jmlzone/freETarget/fpga/pinUsage.ods

Sheet: FPGA pins
# Pin Out For iCE5UP5K (iCE40 UltraPlus - 5K)
# Revision 0.4 - Remove FWG49
# Revision 1.1 - Fix RGB pins, swapped C5 & A5 pins as well as 39 & 41
# Updated Jun 19, 2017
FNC | Pin Type | BANK | Differential Pair | SG48 | Etarget usage | ESP32 pin | UPDunio use
IOB_0a | PIO | 2 |  | 46 | pcm0
IOB_2a | DPIO | 2 | TRUE_of_IOB_3b | 47 | SD0+
IOB_3b_G6 | DPIO/GBIN | 2 | COMP_of_IOB_2a | 44 | SD0-
IOB_4a | DPIO | 2 | TRUE_of_IOB_5b | 48 | SD1+
IOB_5b | DPIO | 2 | COMP_of_IOB_4a | 45 | SD1-
IOB_6a | PIO | 2 |  | 2 | pcm1
IOB_8a | DPIO | 2 | TRUE_of_IOB_9b | 4 | SD2+
IOB_9b | DPIO | 2 | COMP_of_IOB_8a | 3 | SD2-
creset_b | CONFIG | 1 |  | 8 | Config | y |  | prog
CDONE | CONFIG | 1 |  | 7 | Config | y |  | prog
IOB_13b | DPIO | 1 | COMP_of_IOB_12a | 6 | pcm2
IOB_16a | PIO | 1 |  | 9 | pcm3 |  |  | flash
IOB_18a | PIO | 1 |  | 10 | pcm4
IOB_20a | PIO | 1 |  | 11 | pcm5
IOB_22a | DPIO | 1 | TRUE_of_IOB_23b | 12 | SD3+
IOB_23b | DPIO | 1 | COMP_of_IOB_22a | 21 | SD3-
IOB_24a | DPIO | 1 | TRUE_of_IOB_25b | 13 | SD4+
IOB_25b_G3 | DPIO/GBIN | 1 | COMP_of_IOB_24a | 20 | SD4- |  | 12mHZ | flash
IOB_29b | PIO | 1 |  | 19
IOB_31b | PIO | 1 |  | 18
IOB_32a_SPI_SO | DPIO/CONFIG_SPI | 1 |  | 14 | config/ | y |  | prog
IOB_33b_SPI_SI | DPIO/CONFIG_SPI | 1 |  | 17 | config/ | y |  | prog
IOB_34a_SPI_SCK | DPIO/CONFIG_SPI | 1 |  | 15 | config/SCL | y |  | prog
IOB_35b_SPI_SS | DPIO/CONFIG_SPI | 1 |  | 16 | config/SDA | y |  | prog
VCCPLL | VCCPLL |  |  | 29 | power
IOT_36b | DPIO/I3C | 0 | COMP_of_IOT_37a | 25 | SD5-
IOT_37a | DPIO/I3C | 0 | TRUE_of_IOT_36b | 23 | SD5+
IOT_38b | DPIO | 0 | COMP_of_IOT_39a | 27 | compN
IOT_39a | DPIO | 0 | TRUE_of_IOT_38b | 26 | compE
IOT_41a | PIO | 0 |  | 28 | compS
IOT_42b | DPIO | 0 | COMP_of_IOT_43a | 31 | compW
IOT_43a | DPIO | 0 | TRUE_of_IOT_42b | 32
IOT_44b | DPIO | 0 | COMP_of_IOT_45a | 34
IOT_45a_G1 | DPIO/GBIN | 0 | TRUE_of_IOT_44b | 37
IOT_46b_G0 | DPIO/GBIN | 0 |  | 35 | 64 mhz clock
IOT_48b | DPIO | 0 | COMP_of_IOT_49a | 36 | DIP_A
IOT_49a | DPIO | 0 | TRUE_of_IOT_48b | 43 | DIP_B
IOT_50b | DPIO | 0 | COMP_of_IOT_51a | 38 | DIP_C
IOT_51a | DPIO | 0 | TRUE_of_IOT_50b | 42 | DIP_D
RGB2 | LED | 0 |  | 41 |  |  |  | led
RGB1 | LED | 0 |  | 40 |  |  |  | led
RGB0 | LED | 0 |  | 39 |  |  |  | led
GND | GND | GND |  | Paddle | GND
GND | GND | GND |  | Paddle | GND
GND | GND | GND |  | Paddle | GND
VCC | VCC | VCC |  | 5 | power
VCC | VCC | VCC |  | 30 | power
VCCIO_0 | VCCIO | 0 |  | 33 | power
SPI_Vccio1 | VCCIO | 1 |  | 22 | power
VCCIO_2 | VCCIO | 2 |  | 1 | power
VPP_2V5 | VPP | VPP |  | 24 | power
*SG48 GND is connected to package paddle |  |  |  |  |  | m

Sheet: ESP32 pins
ESP32-WROOM-23D_DEV | U | ESP32-DevKitC |  | usage
Pin | Name | Side | Type
1 | VDD33 | left | power | power
2 | en | left | input | nc
3 | A0_IO36 | left | pass | V_REFERENCE | retro compat
4 | A3_IO39 | left | pass | NORTH_ANA | retro compat
5 | A6_IO34 | left | pass | EAST_ANA | retro compat
6 | A7_IO35 | left | pass | SOUTH_ANA | retro compat
7 | A4_IO32 | left | pass | WEST_ANA | retro compat
8 | A5_IO33 | left | pass | SPARE_1
9 | A18_IO25 | left | pass | SPARE_2
10 | A19_IO26 | left | pass | LED_PWM
11 | A17_IO27 | left | pass | RTS_U
12 | A16_IO14 | left | pass | CST_U
13 | A15_IO12 | left | pass | usb2 | DISP TX
14 | GND | left | ground | ground
15 | A14_IO13 | left | pass | usb2 | DISP RX
16 | D2_IO9 | left | pass
17 | D3_IO10 | left | pass
18 | CMD_IO_11 | left | pass
19 | VIN_5V | left | power | power
38 | GND | right | ground | ground
37 | IO23 | right | bidir | vspimosi | to fpspi in
36 | IO22 | right | bidir | Pixels
35 | TX0_IO1 | right | bidir | usb uart | nc
34 | RX0_IO3 | right | bidir | usb uart | nc
33 | IO21 | right | bidir | paper
32 | GND | right | ground | ground
31 | IO19 | right | bidir
30 | IO18 | right | bidir | vspiclk | to spi clock | i2c scl
29 | IO5 | right | bidir | vspics “SS” | to fpga cs | I2c SDA
28 | IO17 | right | bidir | ARX | AUX RX
27 | IO16 | right | bidir | ATX | AUX TX
26 | A10_IO4 | right | pass | FACE_SENSOR
25 | A11_IO0 | right | pass | creset_b | pwm at boot
24 | A12_IO2 | right | pass | cdone | onboard led
23 | A13_IO15 | right | pass | BD_REV
22 | SDI_IO8 | right | bidir
21 | SDO_IO7 | right | bidir
20 | SCK_IO6 | right | bidir
 | not reccomended to use
