jmlzone/freETarget/Documentation/Commissioning.docx

# freETarget

Application Note: Commissioning

SUMMARY

This application note describes the steps needed to put a freETarget into service and trouble shoot problems as they arise.

REQUIRED

- freETarget V2.1 or higher
- Firmware V3.0 or higher

INTRODUCTION

freETarget has built in test software that helps to identify problems in the installation and ensure correct operation.

IMPORTANT

Your freETarget was tested when it was assembled and arrived with the latest firmware and calibrated. Straight out of the box it should work first shot (pun intended).

INSPECTION

After you have assembled the freETarget into the target holder, inspect the following

- The flat cable is pressed firmly into the sensors and signal board
- There are no kinks or sharp bends in the flat cable.
- All of the sensors are correctly installed North through West

POWER ON

When powered on, the LEDs will go through a short cycle RDY – X – Y to indicate that the power has been applied, the software is valid, and the circuit is functioning. See Figure 1 to see the expected operation.

| | | RDY | X | Y
LED
Test
Cycle
Test Timer Circuit
Display Set Point | | | show | set | point
Ready for Operation

Figure 1: Power On Test Cycle

SENSOR TEST

At the beginning of each cycle, the software does a quick check to make sure that the hardware is ready for the next shot. If no errors are found, the RDY LED is illuminated and the circuit is ready to go. If a sensor is not detected, the fault LED is lit and the remaining LEDs are used to identify the faulty sensor

| | | RDY | X | Y
Ready for Operation
North Sensor Failed
East Sensor Failed
South Sensor Failed
West Sensor Failed

Figure 2: Sensor Fault Indication

If the sensors show ready for operation, tapping the face of the sensor will trigger a shot and indicate that the sensor is capable of detecting the projectile. In Figure 3, all of the LEDs are briefly illuminated to show that the shot was detected and sent to the PC.

| | | RDY | X | Y
Ready for Operation
Shot Detected
Ready for Next Shot

Figure 3: LEDs During and After a Shot

CONNECTING TO THE PC

Launch the PC program and make sure that the correct COM port has been selected.

- Press the Setup Icon (Gear Wheel)
- Inspect Hardware
- Verify that the correct COM port is used.
- Press the CONNECT button on the PC program
  - Does the program show CONNECTED?
  - The current firmware version and date is shown?
  - The competition timer starts running?
  - If the answer is no to any of these questions, check the USB cables and the selected COM port

FIRST SHOT

From a distance of 10 meters, fire your first shot into the target.

- Does the shot register on the PC program?
  - No, check the cables and settings

Fire a series of 9 more shots onto the target.

- Do all 10 shots show up on the display?
  - No, check the cables and settings
- Are the shots more-or-less in the correct place?
  - You’re done. Happy Shooting
- Are the shots correct, but the mirror image?
  - The sensors are installed correctly, but mirror image.
  - Swap North and East
  - Swap West and South
  - Go back to the beginning and test the circuit.
- Are the shots correct, but the reversed top and bottom?
  - The sensors are installed correctly, but upside down.
  - Swap North and West
  - Swap South and East
  - Go back to the beginning and test the circuit.

SET TRIGGER POINT

At this moment, your freETarget is working correctly. Once you get confident in how it works, you might want to change the trigger point and try to improve the accuracy. Refer to the Application Note: Setting the Trigger Point for more instructions.
