jmlzone/freETarget/KiCad/Main Board/Electronic Target.pdf

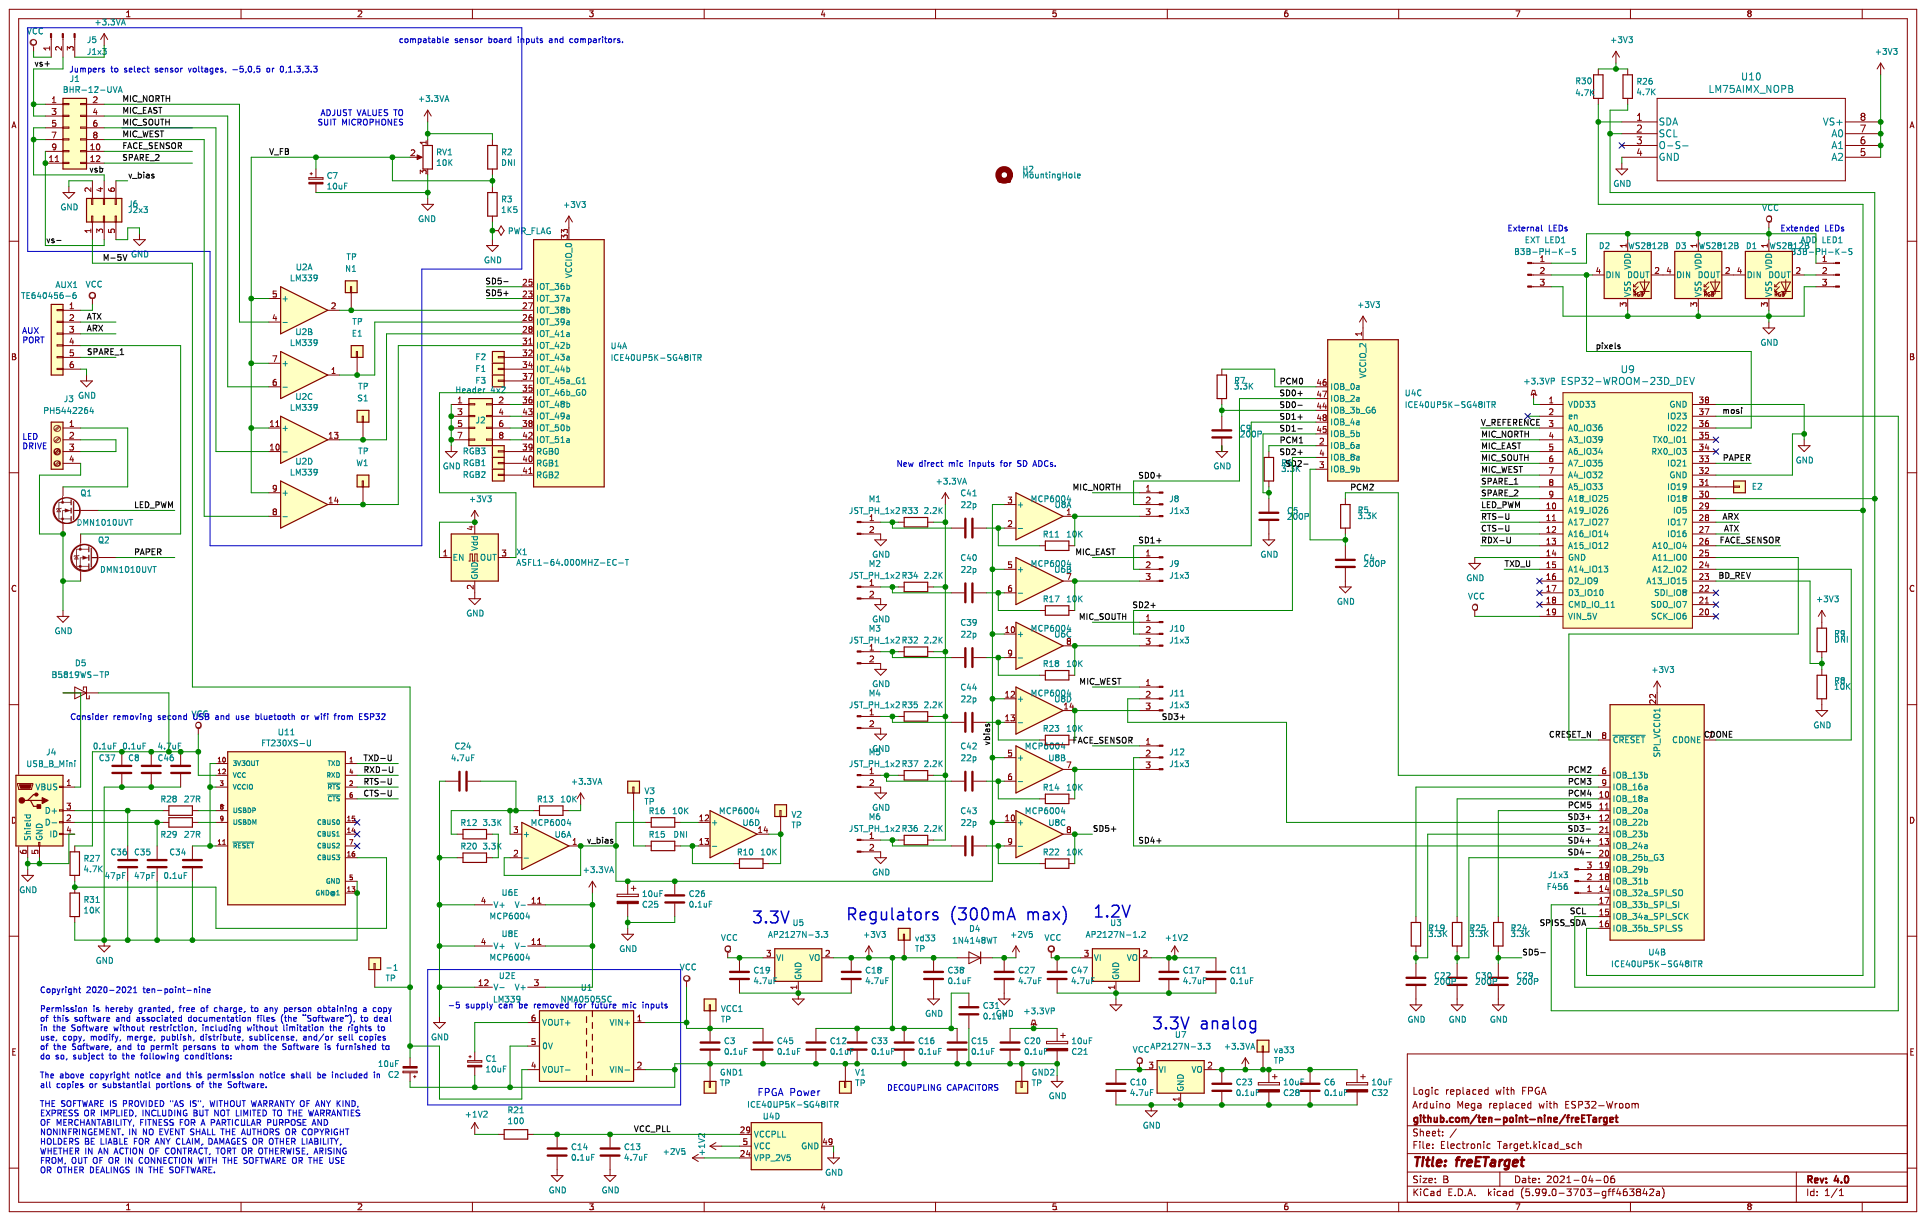
[picture p7: page 1]
