jmlzone/freETarget/KiCad/Main Board/Electronic Target.kicad_sch

## KiCad design KiCad/Main Board/Electronic Target.kicad_sch (2021-06-01)

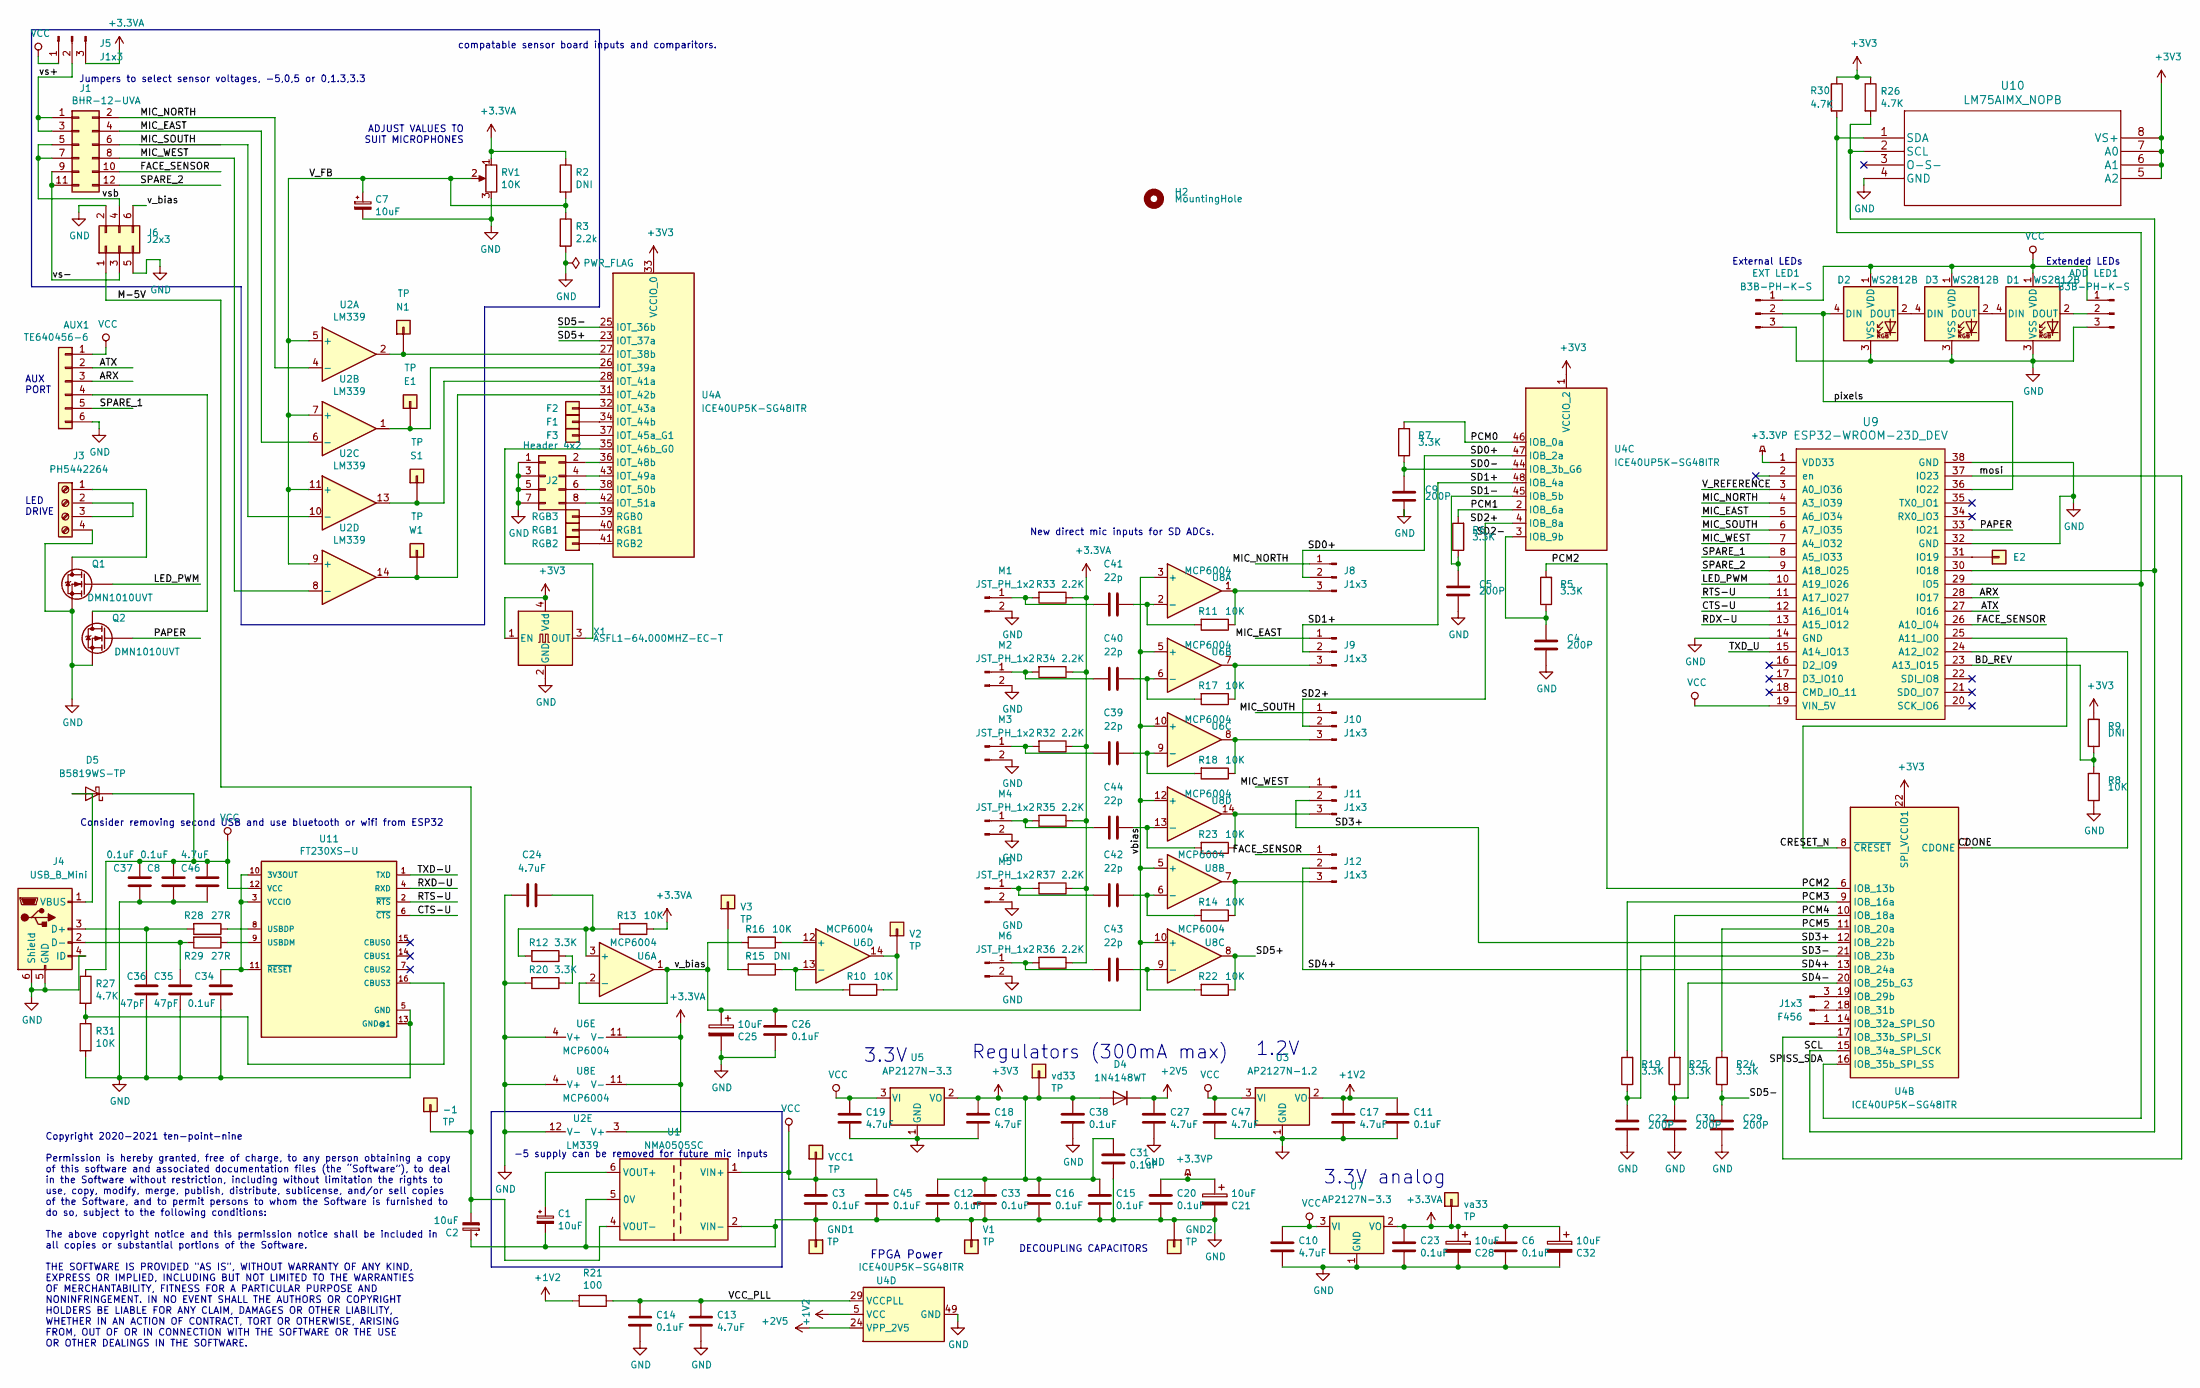
[picture p8: schematic Electronic Target.kicad_sch]

Parts:
-1: TP; PinHeader_1x01_P2.54mm_Vertical
ADD LED1: B3B-PH-K-S; JST_EH_B3B-EH-A_1x03_P2.50mm_Vertical
AUX1: TE640456-6; PinHeader_1x06_P2.54mm_Vertical
C1: 10uF; C_0603_1608Metric; Digikey 478-10742-1-ND
C2: 10uF; C_0603_1608Metric; DigiKey 478-10742-1-ND
C3, C6, C8, C11, C12, C14, C15, C16, C20, C23, C26, C31, C33, C34, C37, C38, C45: 0.1uF; C_0603_1608Metric
C4, C5, C9, C22, C29, C30: 200P; C_0603_1608Metric
C7, C21, C25, C28, C32: 10uF; C_0603_1608Metric
C10, C13, C17, C18, C19, C24, C27, C46, C47: 4.7uF; C_0603_1608Metric
C35, C36: 47pF; C_0603_1608Metric
C39, C40, C41, C42, C43, C44: 22p; C_0603_1608Metric
D1, D2, D3: WS2812B; LED_WS2812B_PLCC4_5.0x5.0mm_P3.2mm
D4: 1N4148WT; D_SOD-523
D5: B5819WS-TP; D_SOD-323
E1, E2: TP; PinHeader_1x01_P2.54mm_Vertical
EXT LED1: B3B-PH-K-S; JST_EH_B3B-EH-A_1x03_P2.50mm_Vertical
F1, F2, F3: TP; PinHeader_1x01_P2.54mm_Vertical
F456: J1x3; PinSocket_1x03_P2.54mm_Vertical
GND1, GND2: TP; PinHeader_1x01_P2.54mm_Vertical
H2: MountingHole; MountingHole_3.7mm
J1: BHR-12-UVA; PinHeader_2x06_P2.54mm_Vertical
J2: Header 4x2; PinHeader_2x04_P2.54mm_Vertical
J3: PH5442264; TerminalBlock_Phoenix_PT-1,5-4-3.5-H_1x04_P3.50mm_Horizontal
J4: USB_B_Mini; USB_Mini-B_Lumberg_2486_01_Horizontal
J5, J8, J9, J10, J11, J12: J1x3; PinSocket_1x03_P2.54mm_Vertical
J6: J2x3; PinHeader_2x03_P2.54mm_Vertical
M1, M2, M3, M4, M5, M6: JST_PH_1x2; JST_PH_B2B-PH-K_1x02_P2.00mm_Vertical
N1: TP; PinHeader_1x01_P2.54mm_Vertical
Q1, Q2: DMN1010UVT; TSOT-23-6
R2, R9, R15: DNI; R_0603_1608Metric
R3: 2.2k; R_0603_1608Metric
R5, R6, R7, R12, R19, R20, R24, R25: 3.3K; R_0603_1608Metric
R8, R10, R11, R13, R14, R16, R17, R18, R22, R23, R31: 10K; R_0603_1608Metric
R21: 100; R_0603_1608Metric
R26, R27, R30: 4.7K; R_0603_1608Metric
R28, R29: 27R; R_0603_1608Metric
R32, R33, R34, R35, R36, R37: 2.2K; R_0603_1608Metric
RGB1, RGB2, RGB3: TP; PinHeader_1x01_P2.54mm_Vertical
RV1: 10K; Potentiometer_Bourns_3314S_Horizontal; DigiKey 987-1014-1-ND
S1: TP; PinHeader_1x01_P2.54mm_Vertical
U1: NMA0505SC; Converter_DCDC_muRata_NMAxxxxSC_THT
U2: LM339; SOIC-14_3.9x8.7mm_P1.27mm
U3: AP2127N-1.2; SOT-23
U4: ICE40UP5K-SG48ITR; QFN-48-1EP_7x7mm_P0.5mm_EP5.6x5.6mm
U5, U7: AP2127N-3.3; SOT-23
U6, U8: MCP6004; SOIC-14_3.9x8.7mm_P1.27mm
U9: ESP32-WROOM-23D_DEV; ESP32-DEVKIT
U10: LM75AIMX_NOPB; SOIC-8_3.9x4.9mm_P1.27mm
U11: FT230XS-U; SSOP-16_3.9x4.9mm_P0.635mm
V1, V2, V3: TP; PinHeader_1x01_P2.54mm_Vertical
VCC1: TP; PinHeader_1x01_P2.54mm_Vertical
W1: TP; PinHeader_1x01_P2.54mm_Vertical
X1: ASFL1-64.000MHZ-EC-T; Oscillator_SMD_Abracon_ASE-4Pin_3.2x2.5mm
va33: TP; PinHeader_1x01_P2.54mm_Vertical
vd33: TP; PinHeader_1x01_P2.54mm_Vertical

Connections:
+1V2: C11.1, C17.1, R21.2, U3.2 (VO), U4.5 (VCC), U4.30 (VCC)
+2V5: C27.1, D4.1 (K), U4.24 (VPP_2V5)
+3.3VA: C6.1, C23.1, C28.1, C32.1, J5.3, R2.1, R13.1, R32.1, R33.1, R34.1, R35.1, R36.1, R37.1, RV1.1, U2.3 (V+), U6.11 (V-), U7.2 (VO), U8.11 (V-), va33.1
+3.3VP: C20.1, C21.1, U9.1 (VDD33)
+3V3: C12.1, C15.1, C16.1, C18.1, C31.1, C33.1, C38.1, D4.2 (A), R9.2, R26.1, R30.1, U4.1 (VCCIO_2), U4.22 (SPI_VCCIO1), U4.33 (VCCIO_0), U5.2 (VO), U10.5 (A2), U10.6 (A1), U10.7 (A0), U10.8 (VS+), X1.1 (EN), X1.4 (Vdd), vd33.1
ARX: AUX1.3, U9.28 (IO17)
ATX: AUX1.2, U9.27 (IO16)
BD_REV: R8.2, R9.1, U9.23 (A13_IO15)
CDONE: U4.7 (CDONE), U9.24 (A12_IO2)
CRESET_N: U4.8 (~CRESET), U9.25 (A11_IO0)
CTS-U: U9.12 (A16_IO14), U11.6 (~CTS)
FACE_SENSOR: J1.10, J12.1, U9.26 (A10_IO4)
GND: ADD LED1.3, AUX1.6, C1.2, C2.1, C3.2, C4.2, C5.2, C6.2, C7.2, C8.2, C9.2, C10.2, C11.2, C12.2, C13.2, C14.2, C15.2, C16.2, C17.2, C18.2, C19.2, C20.2, C21.2, C22.2, C23.2, C24.2, C25.2, C26.2, C27.2, C28.2, C29.2, C30.2, C31.2, C32.2, C33.2, C34.2, C35.2, C36.2, C37.2, C38.2, C45.2, C46.2, C47.2, D1.3 (VSS), D2.3 (VSS), D3.3 (VSS), EXT LED1.3, GND1.1, GND2.1, J2.1, J2.3, J2.5, J2.7, J3.4, J4.4 (ID), J4.5 (GND), J4.6 (Shield), J6.2, J6.5, M1.2, M2.2, M3.2, M4.2, M5.2, M6.2, Q1.4 (S), Q2.4 (S), R3.2, R8.1, R20.2, R31.2, RV1.3, U1.2 (VIN-), U1.5 (0V), U2.12 (V-), U3.1 (GND), U4.49 (GND), U5.1 (GND), U6.4 (V+), U7.1 (GND), U8.4 (V+), U9.14 (GND), U9.32 (GND), U9.38 (GND), U10.4 (GND), U11.5 (GND), U11.13 (GND@1), V1.1, X1.2 (GND)
LED_PWM: Q1.3 (G), U9.10 (A19_IO26)
M-5V: -1.1, C2.2, J6.1, U1.4 (VOUT-)
MIC_EAST: J1.4, J9.1, U2.6 (-), U9.5 (A6_IO34)
MIC_NORTH: J1.2, J8.1, U2.4 (-), U9.4 (A3_IO39)
MIC_SOUTH: J1.6, J10.1, U2.10 (-), U9.6 (A7_IO35)
MIC_WEST: J1.8, J11.1, U2.8 (-), U9.7 (A4_IO32)
unnamed: ADD LED1.2, D1.2 (DOUT)
unnamed: AUX1.4, Q2.1 (D), Q2.2 (D), Q2.5 (D), Q2.6 (D)
unnamed: C1.1, U1.6 (VOUT+)
unnamed: C24.1, R12.2, R13.2, U6.3 (+)
unnamed: C34.1, U11.3 (VCCIO), U11.10 (3V3OUT), U11.11 (~RESET)
unnamed: C35.1, J4.2 (D-), R29.2
unnamed: C36.1, J4.3 (D+), R28.2
unnamed: C39.1, R18.2, U6.9 (-)
unnamed: C39.2, M3.1, R32.2
unnamed: C40.1, R17.2, U6.6 (-)
unnamed: C40.2, M2.1, R34.2
unnamed: C41.1, R11.2, U8.2 (-)
unnamed: C41.2, M1.1, R33.2
unnamed: C42.1, R14.2, U8.6 (-)
unnamed: C42.2, M5.1, R37.2
unnamed: C43.1, R22.2, U8.9 (-)
unnamed: C43.2, M6.1, R36.2
unnamed: C44.1, R23.2, U8.13 (-)
unnamed: C44.2, M4.1, R35.2
unnamed: D1.4 (DIN), D3.2 (DOUT)
unnamed: D2.2 (DOUT), D3.4 (DIN)
unnamed: D5.2 (A), J4.1 (VBUS)
unnamed: E1.1, U2.1, U4.26 (IOT_39a)
unnamed: E2.1, U9.31 (IO19)
unnamed: F1.1, U4.34 (IOT_44b)
unnamed: F2.1, U4.32 (IOT_43a)
unnamed: F3.1, U4.37 (IOT_45a_G1)
unnamed: F456.1, U4.14 (IOB_32a_SPI_SO)
unnamed: F456.2, U4.18 (IOB_31b)
unnamed: F456.3, U4.19 (IOB_29b)
unnamed: J2.2, U4.36 (IOT_48b)
unnamed: J2.4, U4.43 (IOT_49a)
unnamed: J2.6, U4.38 (IOT_50b)
unnamed: J2.8, U4.42 (IOT_51a)
unnamed: J3.1, Q1.1 (D), Q1.2 (D), Q1.5 (D), Q1.6 (D)
unnamed: J3.2, J3.3
unnamed: J8.3, R11.1, U8.1
unnamed: J9.3, R17.1, U6.7
unnamed: J10.3, R18.1, U6.8
unnamed: J11.3, R23.1, U8.14
unnamed: J12.3, R14.1, U8.7
unnamed: N1.1, U2.2, U4.27 (IOT_38b)
unnamed: R10.1, U6.14, V2.1
unnamed: R10.2, R15.1, U6.13 (-)
unnamed: R12.1, R20.1
unnamed: R15.2, V3.1
unnamed: R16.1, U6.12 (+)
unnamed: R27.2, R31.1, U11.16 (CBUS3)
unnamed: R28.1, U11.8 (USBDP)
unnamed: R29.1, U11.9 (USBDM)
unnamed: RGB1.1, U4.40 (RGB1)
unnamed: RGB2.1, U4.41 (RGB2)
unnamed: RGB3.1, U4.39 (RGB0)
unnamed: S1.1, U2.13, U4.28 (IOT_41a)
unnamed: U2.14, U4.31 (IOT_42b), W1.1
unnamed: U4.35 (IOT_46b_G0), X1.3 (OUT)
PAPER: Q2.3 (G), U9.33 (IO21)
PCM0: R7.2, U4.46 (IOB_0a)
PCM1: R6.2, U4.2 (IOB_6a)
PCM2: R5.2, U4.6 (IOB_13b)
PCM3: R19.2, U4.9 (IOB_16a)
PCM4: R25.2, U4.10 (IOB_18a)
PCM5: R24.2, U4.11 (IOB_20a)
RDX-U: U9.13 (A15_IO12)
RTS-U: U9.11 (A17_IO27), U11.2 (~RTS)
RXD-U: U11.4 (RXD)
SCL: R26.2, U4.15 (IOB_34a_SPI_SCK), U9.30 (IO18), U10.2 (SCL)
SD0+: J8.2, U4.47 (IOB_2a)
SD0-: C9.1, R7.1, U4.44 (IOB_3b_G6)
SD1+: J9.2, U4.48 (IOB_4a)
SD1-: C5.1, R6.1, U4.45 (IOB_5b)
SD2+: J10.2, U4.4 (IOB_8a)
SD2-: C4.1, R5.1, U4.3 (IOB_9b)
SD3+: J11.2, U4.12 (IOB_22b)
SD3-: C22.1, R19.1, U4.21 (IOB_23b)
SD4+: J12.2, U4.13 (IOB_24a)
SD4-: C30.1, R25.1, U4.20 (IOB_25b_G3)
SD5+: R22.1, U4.23 (IOT_37a), U8.8
SD5-: C29.1, R24.1, U4.25 (IOT_36b)
SPARE_1: AUX1.5, U9.8 (A5_IO33)
SPARE_2: J1.12, U9.9 (A18_IO25)
SPISS_SDA: R30.2, U4.16 (IOB_35b_SPI_SS), U9.29 (IO5), U10.1 (SDA)
TXD-U: U11.1 (TXD)
TXD_U: U9.15 (A14_IO13)
VCC: ADD LED1.1, AUX1.1, C3.1, C8.1, C10.1, C19.1, C37.1, C45.1, C46.1, C47.1, D1.1 (VDD), D2.1 (VDD), D3.1 (VDD), D5.1 (K), EXT LED1.1, J5.1, R27.1, U1.1 (VIN+), U3.3 (VI), U5.3 (VI), U7.3 (VI), U9.19 (VIN_5V), U11.12 (VCC), VCC1.1
VCC_PLL: C13.1, C14.1, R21.1, U4.29 (VCCPLL)
V_FB: C7.1, R2.2, R3.1, RV1.2, U2.5 (+), U2.7 (+), U2.9 (+), U2.11 (+)
V_REFERENCE: U9.3 (A0_IO36)
mosi: U4.17 (IOB_33b_SPI_SI), U9.37 (IO23)
pixels: D2.4 (DIN), EXT LED1.2, U9.36 (IO22)
v_bias: C25.1, C26.1, J6.6, R16.2, U6.1, U6.2 (-), U6.5 (+), U6.10 (+), U8.3 (+), U8.5 (+), U8.10 (+), U8.12 (+)
vs+: J1.1, J1.3, J5.2
vs-: J1.9, J1.11, J6.3
vsb: J1.5, J1.7, J6.4

Notes on the sheet:
AUX PORT
LED DRIVE
Copyright 2020-2021 ten-point-nine Permission is hereby granted, free of charge, to any person obtaining a copy of this software and associated documentation files (the “Software”), to deal in the Software without restriction, including without limitation the rights to use, copy, modify, merge, pub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
Jumpers to select sensor voltages, -5,0,5 or 0,1.3,3.3
Consider removing second USB and use bluetooth or wifi from ESP32
compatable sensor board inputs and comparitors.
ADJUST VALUES TO SUIT MICROPHONES
-5 supply can be removed for future mic inputs
3.3V
FPGA Power
Regulators (300mA max)
DECOUPLING CAPACITORS
New direct mic inputs for SD ADCs.
1.2V
3.3V analog
External LEDs
Extended LEDs
