jmlzone/freETarget/Software/Arduino/freETarget/freETarget.ino

/*----------------------------------------------------------------
 * 
 * freETarget        
 * 
 * Software to run the Air-Rifle / Small Bore Electronic Target
 * 
 *-------------------------------------------------------------*/
#include "io_includes.h"
#include "compute_hit.h"
#include "EEPROM.h"
#include "nonvol.h"
#include "mechanical.h"
#include "diag_tools.h"
#include "i2c_bb.h"

history_t history;  

double       s_of_sound;                // Speed of sound
unsigned int shot = 0;                  // Shot counter
bool         face_strike = 0;           // Miss indicator
bool         is_trace = false;          // TRUE if trace is enabled

const char* names[] = { "ANON",    "BOSS",   "MINION",
                        "DOC",     "DOPEY",  "HAPPY",   "GRUMPY", "BASHFUL", "SNEEZEY", "SLEEPY",
                        "RUDOLF",  "DONNER", "BLITXEM", "DASHER", "PRANCER", "VIXEN",   "COMET", "CUPID", "DUNDER",
                        "ODIN",    "WODEN",   "THOR",   "BALDAR",
                        0};
                  
char* nesw = "NESW";                    // Cardinal Points
#ifdef ESP32
  #if CONFIG_IDF_TARGET_ESP32S2
   #define VSPI FSPI
  #endif
  #include <HardwareSerial.h>
  HardwareSerial AUX_SERIAL(2);
  HardwareSerial DISPLAY_SERIAL(1);
  BluetoothSerial BT_Serial;
  SPIClass * vspi = NULL;
  extern uint8_t i2c_buf[16];
#endif
/*----------------------------------------------------------------
 * 
 * function: setup()
 * 
 * brief: Initialize the board and prepare to run
 * 
 * return: None
 * 
 *--------------------------------------------------------------*/

void setup(void) 
{
  int i;
    
/*
 *  Setup the serial port
 */
  Serial.begin(115200);
#ifdef ESP32
  AUX_SERIAL.begin(115200,SERIAL_8N1,AUX_RX,AUX_TX); 
  DISPLAY_SERIAL.begin(115200,SERIAL_8N1,DISPLAY_RX,DISPLAY_TX);
  if(!BT_Serial.begin("Etarget")) {
    Serial.print("Eror starting bluetooth\n");
  }
  pinMode(SS, OUTPUT); //VSPI SS
  pinMode(CRESET_B, OUTPUT);
  if(!SPIFFS.begin()){
    Serial.println("SPIFFS Mount Failed");
    return;
  }
  Serial.println("SPIFFS start ok");
  listDir(SPIFFS, "/", 0);
  spiSendFileToFPGA("/etarget.bin");
  #ifdef I2C_BB
  i2cbb_init();
  #else
  Wire.begin(5,18,1200000); // 5 was SS for download now SDA, 18 was SCK for download now SCL
  Wire.setTimeOut(100);
  #endif
#else
  AUX_SERIAL.begin(115200); 
  DISPLAY_SERIAL.begin(115200); 
#endif

  PRINT("\r\nfreETarget "); PRINT(SOFTWARE_VERSION); PRINT("\r\n");

/*
 *  Set up the port pins
 */
  init_gpio();  
  init_sensors();
  init_analog_io();
  randomSeed( analogRead(V_REFERENCE));   // Seed the random number generator
  is_trace = read_DIP() & (VERBOSE_TRACE);
     
/*
 * Initialize variables
 */
  read_nonvol();
  
/*
 * Run the power on self test
 */
  POST_version(PORT_ALL);             // Show the version string on all ports
  show_echo(0);
  POST_LEDs();                        // Cycle the LEDs
  while ( (POST_counters() == false)  // If the timers fail
              && !is_trace)           // and not in trace mode 
  {
    Serial.print("\n\rPOST_2 Failed\n\r");  // Blink the LEDs
    blink_fault(POST_COUNT_FAILED);         // and try again
  }
  POST_trip_point();                  // Show the trip point
  
/*
 * Turn off the self test
 */ 
  switch (json_test)
  {
    case T_HELP:
    case T_PAPER:
    case T_PASS_THRU:
    case T_SET_TRIP:
    case T_XFR_LOOP:
      json_test = T_HELP;
      break;

    default:
      Serial.print("\r\nStarting Test: "); Serial.print(json_test);
      break;
  }

/*
 * Ready to go
 */
  set_LED_PWM(json_LED_PWM);
  
  return;
}

/*----------------------------------------------------------------
 * 
 * function: loop()
 * 
 * brief: Main control loop
 * 
 * return: None
 * 
 *----------------------------------------------------------------
 */
#define SET_MODE      0         // Set the operating mode
#define ARM       (SET_MODE+1)  // State is ready to ARM
#define WAIT      (ARM+1)       // ARM the circuit
#define AQUIRE    (WAIT+1)      // Aquire the shot
#define REDUCE    (AQUIRE+1)    // Reduce the data
#define WASTE     (REDUCE+1)    // Wait for the shot to end
#define SEND_MISS (WASTE+1)     // Got a trigger, but was defective

unsigned int state = SET_MODE;
unsigned long now;              // Interval timer 
unsigned long power_save;       // Power save timer
unsigned int sensor_status;     // Record which sensors contain valid data
unsigned int location;          // Sensor location 
unsigned int i, j;              // Iteration Counter
int ch;
unsigned int shot_number;

void loop() 
{

/*
 * Take care of any commands coming through
 */
  if ( read_JSON() )
  {
    now = micros();               // Reset the power down timer if something comes in
    set_LED_PWM(json_LED_PWM);    // Put the LED back on if it was off
  }

/*
 * Cycle through the state machine
 */
  switch (state)
  {

/*
 *  Check for special operating modes
 */
  default:
  case SET_MODE:
    is_trace = read_DIP() & (VERBOSE_TRACE);     // Turn on tracing if the DIP switch is in place
    
    if ( read_DIP() & CALIBRATE )
    {
      set_trip_point(0);              // Are we calibrating?
    }
    
    if ( json_test != 0 )
    {
      self_test(json_test);           // Run the self test
    }
    
    state = ARM;                      // Carry on to the target
    
    break;
/*
 * Arm the circuit
 */
  case ARM:
    arm_counters();
    enable_interrupt();               // Turn on the face strike interrupt
    face_strike = false;              // Reset the face strike count
    
    set_LED_PWM(json_LED_PWM);        // Keep the LEDs ON

    sensor_status = is_running();
    power_save = micros();            // Start the power saver time
    
    if ( sensor_status == 0 )
    { 
      if ( is_trace )
      {
        Serial.print("\r\n\nWaiting...");
      }
      set_LED(SHOT_READY);   
      state = WAIT;             // Fall through to WAIT
    }
    else
    {
      if ( sensor_status & TRIP_NORTH  )
      {
        Serial.print("\r\n{ \"Fault\": \"NORTH\" }");
        set_LED(NORTH_FAILED);           // Fault code North
        delay(ONE_SECOND);
      }
      if ( sensor_status & TRIP_EAST  )
      {
        Serial.print("\r\n{ \"Fault\": \"EAST\" }");
        set_LED(EAST_FAILED);           // Fault code East
        delay(ONE_SECOND);
      }
      if ( sensor_status & TRIP_SOUTH )
      {
        Serial.print("\r\n{ \"Fault\": \"SOUTH\" }");
        set_LED(SOUTH_FAILED);         // Fault code South
        delay(ONE_SECOND);
      }
      if ( sensor_status & TRIP_WEST )
      {
        Serial.print("\r\n{ \"Fault\": \"WEST\" }");
        set_LED(WEST_FAILED);         // Fault code West
        delay(ONE_SECOND);
      }     
    }
    break;
    
/*
 * Wait for the shot
 */
  case WAIT:
    if ( (json_power_save != 0 ) 
        && (((micros()-power_save) / 1000000 / 60) >= json_power_save) )
    {
      set_LED_PWM(0);                     // Dim the lights?
    }

    sensor_status = is_running();

    if ( face_strike )                    // Something hit the front
    {
      state = SEND_MISS;                  // Show it's a miss
      break;
    }

    if ( sensor_status != 0 )             // Shot detected
    {
      now = micros();                     // Remember the starting time
      set_LED(L('-', '*', '-'));                   // No longer waiting
      state = AQUIRE;
    }
    break;

/*
 *  Aquire the shot              
 */  
  case AQUIRE:
    if ( (micros() - now) > SHOT_TIME )   // Enough time already
    { 
      stop_counters(); 
      state = REDUCE;                     // 3, 4 Have enough data to performe the calculations
    }
    break;

 
/*
 *  Reduce the data to a score
 */
  case REDUCE:   
    if ( is_trace )
    {
      Serial.print("\r\nTrigger: "); 
      show_sensor_status(sensor_status);
      Serial.print("\r\nReducing...");
    }
    set_LED(L('*', '*', '*'));                   // Light All
    location = compute_hit(sensor_status, &history, false);

    if ( (timer_value[N] == 0) || (timer_value[E] == 0) || (timer_value[S] == 0) || (timer_value[W] == 0) ) // If any one of the timers is 0, that's a miss
    {
      state = SEND_MISS;
      delay(ONE_SECOND);
      break;
    }
    send_score(&history, shot_number, sensor_status);
    state = WASTE;
    shot_number++;                   
    break;
    

/*
 *  Wait here to make sure the RUN lines are no longer set
 */
  case WASTE:
    delay(ONE_SECOND/2);                      // Hang out for a second
    if ( (json_paper_time * PAPER_STEP) > (PAPER_LIMIT) )
    {
      json_paper_time = 0;                    // Check for an infinit loop
    }
    if ( json_paper_time != 0 )
    {
      drive_paper();
    }
    state = SET_MODE;
    break;

/*    
 * Show an error occured
 */
  case SEND_MISS:   
    state = SET_MODE;                         // Next time go to waste time 
    
    if ( is_trace )
    {
      Serial.print("\r\nFace Strike...\r\n");
    } 

    face_strike = false;

    blink_fault(SHOT_MISS);
    
    if ( json_send_miss != 0)
    {
      send_miss(shot);
    }
    break;
    }

/*
 * All done, exit for now
 */
  return;
}
