jmlzone/freETarget/Software/Arduino/freETarget/diag_tools.h

/*----------------------------------------------------------------
 *
 * diag_tools.h
 *
 * Debug and test tools 
 *
 *---------------------------------------------------------------*/

#define T_HELP         0       // Help test
#define T_DIGITAL      1       // Digital test
#define T_TRIGGER      2       // Test microphone trigger
#define T_CLOCK        3       // Trigger clock internally
#define T_OSCOPE       4       // Microphone digital oscilliscope
#define T_OSCOPE_PC    5       // Display oscillisope on PC
#define T_PAPER        6       // Advance paper backer
#define T_SPIRAL       7       // Generate sprial pattern
#define T_GRID         8       // Generate grid pattern
#define T_ONCE         9       // Generate single calculation @ 45North
#define T_PASS_THRU   10       // Serial port pass through
#define T_SET_TRIP    11       // Set the microphone trip point
#define T_XFR_LOOP    12       // Transfer loopback
#define T_SERIAL_PORT 13       // Hello World
#define T_LED         14       // Test the PWM
#define T_FACE        15       // Test the face detector

/*
 * LED status messages
 */
// Normal operation        RDY Light On
#define SHOT_READY         L('*', '.', '.') // The shot is ready to go
#define SHOT_DONE          L('*', '*', '*') // A shot has been detected


// Sensor failed while waiting for a shot X Light On
#define NORTH_FAILED       L('.', '*', '.') // North sensor failed
#define EAST_FAILED        L('.', '*', '*') // East sensor failed
#define SOUTH_FAILED       L('*', '*', '*') // South sensor failed
#define WEST_FAILED        L('*', '*', '.') // West sensor failed

// Spare                   Y light On
#define UNUSED_1           L('.', '.', '*')
#define UNUSED_2           L('*', '-', '*')

// Blinking fault message
#define POST_COUNT_FAILED  0b001            // LED fault code
#define VREF_OVER_UNDER    0b010            // Trip point over or under spec
#define UNUSED_2           0b100
#define SHOT_MISS          0b000            // Shot missed

void self_test(uint16_t test);
void show_sensor_status(unsigned int sensor_status);  // Display the sensor status as text
void blink_fault(unsigned int fault_code);            // Blink a fault
void POST_version(int16_t port);// Show the version string
void POST_LEDs(void);           // Verify the LED operation
bool POST_counters(void);       // Verify the counter operation
void POST_trip_point(void);     // Display the set point
static void show_analog_on_PC(int v);
static void unit_test(unsigned int mode);
static bool sample_calculations(unsigned int mode, unsigned int sample);
void set_trip_point(int v);
