jmlzone/freETarget/(commit log)

2021-04-18 start FPGA simulatons
    new file: ../../KiCad/Main Board/Electronic Target.kicad_prl
    new file: ../../KiCad/Main Board/Electronic Target.kicad_pro
    new file: ../../KiCad/Main Board/Electronic Target.kicad_sch
    modified: ../../KiCad/Main Board/Electronic Target.pdf
    modified: ../../KiCad/Main Board/sym-lib-table
    new file: ../../KiCad/Main Board/wroom.lib
    new file: ../README.md
    new file: ../pinUsage.ods
    new file: adc_drv.sv
    new file: etarget.cmd
    new file: i2c_master.sv
    new file: run.sh
    new file: tb_etarget.sv
    new file: test_sd_adc.sv
    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
    [Electronic Target.kicad_sch, pinUsage.ods]
2021-04-19 clean up I2c transactions, start on ADC functions
2021-04-27 esp 32 staging
    [Electronic Target.kicad_sch, pinUsage.ods]
2021-04-27 esp32 versions
2021-04-28 initial clean compiles of FPGA and ESP32 arduino code-- untested
    [Electronic Target.kicad_sch, pinUsage.ods]
2021-05-08 initial laypout
    [Electronic Target.kicad_sch, pinUsage.ods]
2021-05-14 esp32 functions merged and compiling for mega and esp32
2021-05-19 got rid of the i2c gremins and can pass post1,2,3
2021-05-25 board updates for development board
    [Electronic Target.kicad_sch]
2021-06-01 stage for next merge
    [Electronic Target.kicad_sch]
